2-hardcore-4-u/RobotDesign2025/Latex/readme.txt

Latex-Vorlage zur Erstellung eines Laborberichtes

Empfohlene Software:

Miktex als Latex-Engine

Als Latex-Editor 
TexnicCenter (Freeware, http://www.toolscenter.org/front_content.php?idcat=26)

Jabref (Freeware, http://sourceforge.net/projects/jabref/) für die Bibliotheksverwaltung
