2-hardcore-4-u/RobotDesign2025/report.pdf

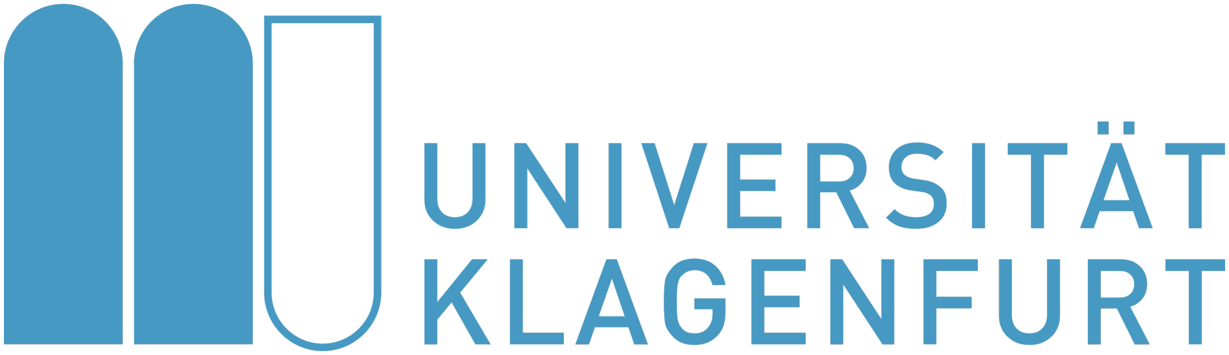
[picture p13: figure]

## University of Klagenfurt

# Basic Lab: Robot Design

## Summer Semester 2024

# Final Report

## Group B

## Bozhidar Bozhikov Nikita Smolianinov Vladyslav Uhrik

## Supervisors: Dr. Narendiran Anandan Serkan Ergun July 11, 2025

## Contents

1 Task Description (Bozhidar Bozhikov) | 2
2 Specifications (Bozhidar Bozhikov, Vladyslav Uhrik) | 2
3 Hardware and CAD (Nikita Smolianinov) | 5
4 PCB (Bozhidar Bozhikov) | 6
5 Discussion (Bozhidar Bozhikov) | 6

1

KS Basic Lab: Robot Design | SS 2025

## 1 Task Description (Bozhidar Bozhikov)

The goal behind this project is to design a circular robot (diam. = 30cm) with nominal speed 100mm/s. The robot must also fullfill the following requirements:

a) be able to clear gaps of 6cm,
b) be able to operate in darkness,
c) be able to run for a minimum of 15 minutes,
d) have line-tracking capability,
e) have RC capability,
f) be able to give acoustic feedback ( 75dB)
g) have maximum weight 800g,
h) fit in a budget of 300¤

The design we decided to develop is inspired by real-world screw-propelled vehicles, which are moved with the help of a pair of rotating helix-shaped cylinders made of soft plastic or rubber. The cylinders have a spiral form like the thread of a screw which make contact with the ground. Motion is produced by the inverse of the screw conveyor: one cylinder’s helix runs clockwise and the other - counterclockwise. Rotation is done with the activation of only one of the corresponding cylinders. This form of propulsion is used in real life to move through difficult terrain such as ice, mud, snow and water. As such, our robot would ideally operate on carpet (simulating mud and swamp) or on very smooth ground (simulating ice).
The github repository used can be found here. (https://github.com/2-hardcore-4-u/RobotDesign2025)

## 2 Specifications (Bozhidar Bozhikov, Vladyslav Uhrik)

### 2.1 Physical Calculations (Vladyslav Uhrik)

Step 1: Define Requirements Target speed = 0.1 m/s (100 mm/s) Helix pitch (measured or estimated) = 2 cm = 0.02 m Robot mass = 0.8 kg Wheel radius = 6 cm = 0.06 m Surface type = linoleum or carpet friction coefficient µ=0.4

2

Step 2: Calculate Required RPM We assume 1 full revolution of the helix moves the robot forward by 1 pitch length.

Revolutions per second (RPS) = Linear speed Helix pitch =

0.1
0.02

= 5 rev/sec

Helix pitch = the axial distance (i.e., forward movement along the wheel’s centerline) that the thread travels in one full 360◦
rotation around the wheel.

RPM = 5 * 60 = 300 RPM

Step 3: Calculate Normal Force per Wheel Assume equal weight distribution across two wheels:

FN =

m · g
2

=

0.8 kg × 9.81 m/s²

2
= 3.924 N
Step 4: Calculate Friction Force (Required to Move)

Ffriction = µ · FN
= 0.4 × 3.924 N
= 1.57 N
Step 5: Calculate Required Torque per Wheel

τ = F · r
= 1.57 N × 0.06 m
= 0.0942 Nm

Apply Safety Margin (1.5Ö)

τsafe = 0.0942 × 1.5
= 0.1413 N m
Step 6: Convert RPM to Angular Velocity

ω =

2π × RPM
60

=

2π × 300
60
= 31.42 rad s⁻¹

3

Step 7: Calculate Mechanical Power per Motor

P = τ × ω
= 0.1413 N m × 31.42 rad s⁻¹

= 4.44W per motor

Total Power for 2 Motors

Pmotors = 2 × 4.44W
= 8.88W

### 2.2 Electrical Power Calculations (Vladyslav Uhrik)

Step 8: System Power Budget We calculate the power P of each component using the formula: P = V I

Table 1: Component Power Consumption
Component | V (V) I (A) P (W) Notes
ATmega32 | 5.0 | 0.020 | 0.10 | Powered from 5V rail
8P MCU
nRF24L01 | 3.3 | 0.012 | 0.04 | Powered from 3.3V rail

P RF module

VL53L1X | 2.8 | 0.019 | 0.05 | Direct 2.8V rail or on- board LDO

ToF sensor

TP4056 | 5.0 | 1.000 | 5.00 | During charging (in- put)

charger module

MT3608 | 12.0 | 0.010 | 0.12 | Estimated conversion overhead

(regulator loss)

IIM-42652 | 3.3 | 0.007 | 0.023 | Motion tracking
CNY70 | 5.0 | 0.018 | 0.09 | IR sensor (emitter + transistor)

IR sensor

Buzzer (passive) | 5.0 | 0.030 | 0.15 | Approx. 75 dB
2x Pololu Stepper | 2.8 | 3.400 | 9.52 | Two motors: 1.7 A×2
Motors

Total Power = 24.613 W

| | 4

Step 9: Energy Required for 15 Minutes Convert 15 min to hours:

E = 24.613 ∗ 0.25 = 6.15325W h

Step 10: Calculate Battery Capacity at 12V

C =

6.15325
12
= 512.77 mA h

Add 30% Safety Margin:

Csafe = 512.77 × 1.3
= 666.6 mA h

Voltage: 12 V

Minimum capacity: 670 mA h (rounded up) (we end up using a 1000 mA h battery)

## 3 Hardware and CAD (Nikita Smolianinov)

The Fusion model discussed in this section can be found in the .stp file. The robot’s design follows real-world screw-propelled vehicles such as the ZIL-2906 and other Amphirols. The circular mount of the robot is made from 4mm thick plywood, with the propulsion cylinders attached with a custom 3D-printed mount, which are driven by 2 bipolar stepper motors, chosen for their power and precision. The stepper motors provide 3 degrees of movement.


Figure 1: Bottom-down view of the CAD model.

5

## 4 PCB (Bozhidar Bozhikov)

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

GPIO08: RF chip select

GPIO09: RF MISO

GPIO10: RF MOSI

GPIO11: RF clock

GPIO12: IR sensor 1

GPIO13: IR sensor 2

GPIO22, GPIO23: pulse input (STEP) and direction control (DIR) respectively for motor 1

GPIO24, GPIO25: pulse input (STEP) and direction control (DIR) respectively for motor 2

GPIO26: buzzer

GPIO27: RF enable

## 5 Discussion (Bozhidar Bozhikov)

The robot discussed in this report follows a real-world practical, albeit unorthodox, design utilizing the screw conveyor mechanism for propulsion on rough carpeted surfaces or smooth ground with 3 degrees of movement.

6


Figure 2: nRF24L01+ single-chip RF transciever, featuring a 16Mhz clock and an antenna.


Figure 3: Motor driver sub-circuit.


Figure 4: Top-down view of the custom pcb.

7
