2-hardcore-4-u/RobotDesign2025/Latex/Figures/1926_Fordson_snowmobile.jpg

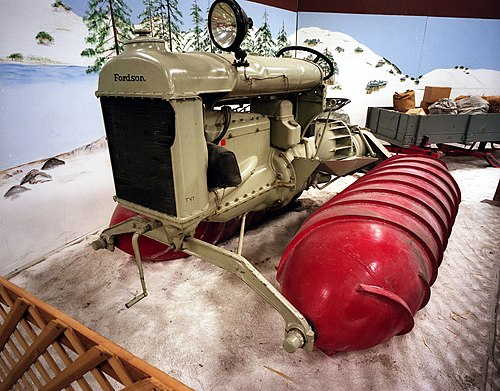
Latex/Figures/1926_Fordson_snowmobile.jpg
