2-hardcore-4-u/RobotDesign2025/BillOfMaterials/Bill of Materials.xlsx

Cost Overview
Item | Cost per Unit €/Unit | Units | Sum | Source /Comment
PLA [kg] | 30 | 0.25 | 7.5 | [1]
Electricity [hrs] | 0.06 | 10 | 0.6 | [1]
Bipolar Stepper Motor [pcs] | 32 | 2 | 64 | [2]
Custom PCB [pcs] | 50 | 1 | 50 | [1]
Small parts [pcs] | 0.5 | 20 | 10 | [1]
Loudspeaker [pcs] | 7 | 1 | 7 | [2]
Microcontroller [pcs] | 2.37 | 1 | 2.37 | [2]
RF Transciever [pcs] | 3.65 | 1 | 3.65 | [3]
Time of Flight Sensor [pcs] | 9.61 | 1 | 9.61 | [4]
Battery Charger Module [pcs] | 1.58 | 1 | 1.58 | [5]
DC Regulator [pcs] | 1.75 | 1 | 1.75 | [6]
6 Axis IMU [pcs] | 6.53 | 1 | 6.53 | [7]
Proximity Sensor [pcs] | 0.74 | 2 | 1.48 | [8]
Raspberry Pi 4 [pcs] | 54 | 1 | 54 | [9]
Battery [pcs] | 12.27 | 1 | 12.27
max allowed cost |  | 300 | 232.34
Sources:
[1] Values as found in template
[2] Document Atmel-7810-Automotive-Microcontrollers-ATmega328P_Datasheet.pdf
[3] Document nRF24L01P_Product_Specification_1_0
[4] Document vl53l1x-1.pdf
[5] Document TP4056.pdf
[6] Document MT3608.pdf
[7] Document ds-000440-iim-42652-typ-v1.1.pdf
[8] Document Atmel-7810-Automotive-Microcontrollers-ATmega328P_Datasheet.pdf
[9] Document raspberry-pi-4-datasheet.pdf
