2-hardcore-4-u/RobotDesign2025/Latex/Figures/UNI_KLU_Logo_cmyk.pdf

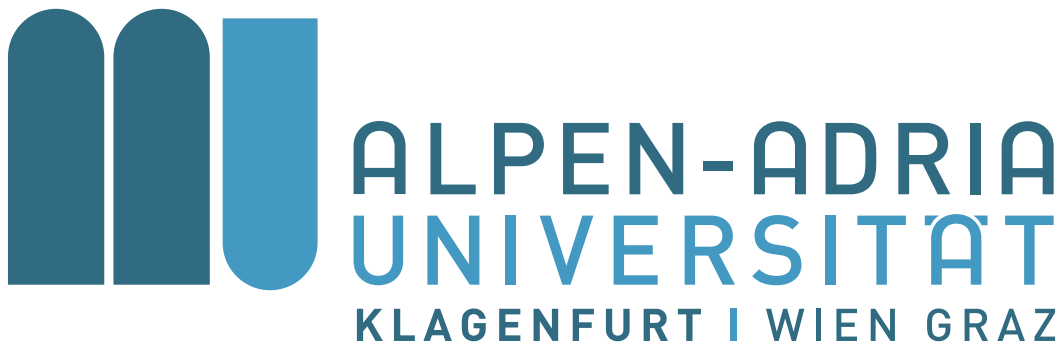
[picture p16: page 1]
