2-hardcore-4-u/RobotDesign2025/pcb/robotdesign.kicad_pcb

## KiCad design pcb/robotdesign.kicad_pcb (2025-06-23)

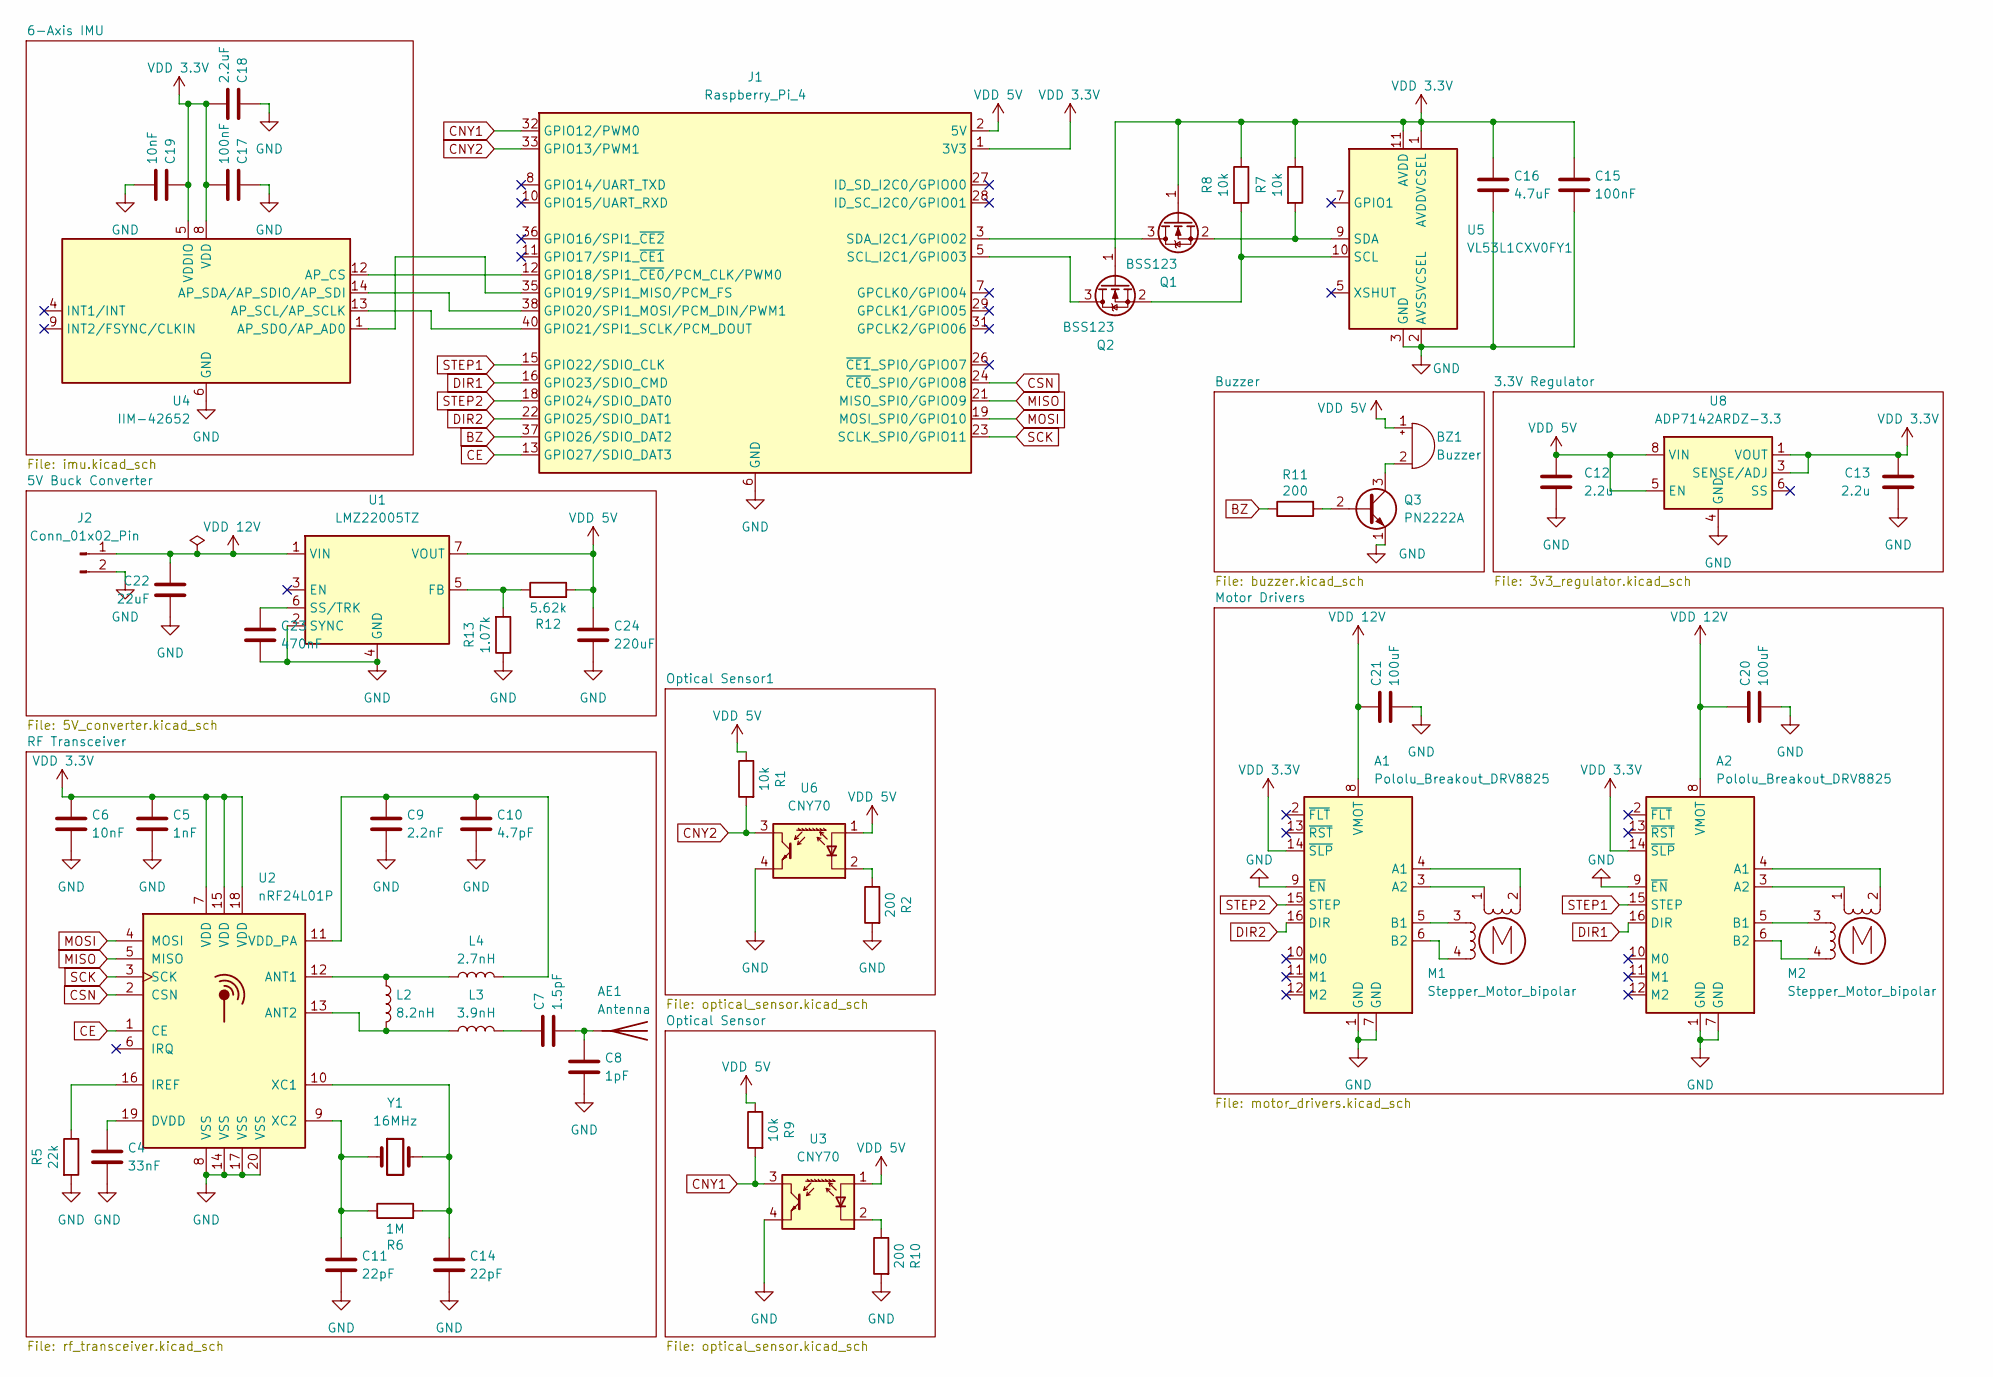
[picture p17: schematic robotdesign.kicad_sch]

Parts:
A1, A2: Pololu_Breakout_DRV8825; Pololu_Breakout-16_15.2x20.3mm
AE1: Antenna; NiceRF_SW868-TH13_868Mhz
BZ1: Buzzer; Buzzer_12x9.5RM7.6
C4: 33nF; C_0201_0603Metric
C5: 1nF; C_0201_0603Metric
C6, C19: 10nF; C_0201_0603Metric
C7: 1.5pF; C_0201_0603Metric
C8: 1pF; C_0201_0603Metric
C9: 2.2nF; C_0201_0603Metric
C10: 4.7pF; C_0201_0603Metric
C11, C14: 22pF; C_0201_0603Metric
C12, C13: 2.2u; C_0805_2012Metric
C15, C17: 100nF; C_0201_0603Metric
C16: 4.7uF; C_0201_0603Metric
C18: 2.2uF; C_0201_0603Metric
C20, C21: 100uF; C_0201_0603Metric
C22: 22uF; C_0201_0603Metric
C23: 470nF; C_0201_0603Metric
C24: 220uF; C_0201_0603Metric
J1: Raspberry_Pi_4; PinHeader_2x20_P2.54mm_Vertical
J2: Conn_01x02_Pin; AMASS_XT30U-F_1x02_P5.0mm_Vertical
L2: 8.2nH; L_6.3x6.3_H3
L3: 3.9nH; L_6.3x6.3_H3
L4: 2.7nH; L_6.3x6.3_H3
M1, M2: Stepper_Motor_bipolar; PinHeader_1x04_P2.54mm_Vertical
Q1, Q2: BSS123; SOT-23
Q3: PN2222A; TO-92_Inline
R1, R7, R8, R9: 10k; R_0201_0603Metric
R2, R10, R11: 200; R_0201_0603Metric
R5: 22k; R_0201_0603Metric
R6: 1M; R_0201_0603Metric
R12: 5.62k; R_0201_0603Metric
R13: 1.07k; R_0201_0603Metric
U1: LMZ22005TZ; Texas_NDW-7_TabPin4
U2: nRF24L01P; QFN-20-1EP_4x4mm_P0.5mm_EP2.5x2.5mm
U3, U6: CNY70; Vishay_CNY70
U4: IIM-42652; Bosch_LGA-14_3x2.5mm_P0.5mm
U5: VL53L1CXV0FY1; ST_VL53L1x
U8: ADP7142ARDZ-3.3; SOIC-8-1EP_3.9x4.9mm_P1.27mm_EP2.29x3mm
Y1: 16MHz; Crystal_AT310_D3.0mm_L10.0mm_Horizontal

Connections:
BZ: J1.37 (GPIO26/SDIO_DAT2), R11.1
CE: J1.13 (GPIO27/SDIO_DAT3), U2.1 (CE)
CNY1: J1.32 (GPIO12/PWM0), R9.2, U3.3 (C)
CNY2: J1.33 (GPIO13/PWM1), R1.2, U6.3 (C)
CSN: J1.24 (~CE0_SPI0/GPIO08), U2.2 (CSN)
DIR1: A2.16 (DIR), J1.16 (GPIO23/SDIO_CMD)
DIR2: A1.16 (DIR), J1.22 (GPIO25/SDIO_DAT1)
GND: A1.1 (GND), A1.7 (GND), A1.9 (~EN), A2.1 (GND), A2.7 (GND), A2.9 (~EN), C4.2, C5.2, C6.2, C8.2, C9.2, C10.2, C11.2, C12.1, C13.1, C14.2, C15.2, C16.2, C17.1, C18.1, C19.2, C20.2, C21.2, C22.2, C23.2, C24.2, J1.6 (GND), J1.9 (GND), J1.14 (GND), J1.20 (GND), J1.25 (GND), J1.30 (GND), J1.34 (GND), J1.39 (GND), J2.2, Q3.1 (E), R2.2, R5.2, R10.2, R13.1, U1.2 (SYNC), U1.4 (GND), U2.8 (VSS), U2.14 (VSS), U2.17 (VSS), U2.20 (VSS), U3.4 (E), U4.6 (GND), U4.7 (GND), U5.2 (AVSSVCSEL), U5.3 (GND), U5.4 (GND), U5.6 (GND), U5.12 (GND), U6.4 (E), U8.4 (GND), U8.9 (GND)
MISO: J1.21 (MISO_SPI0/GPIO09), U2.5 (MISO)
MOSI: J1.19 (MOSI_SPI0/GPIO10), U2.4 (MOSI)
unnamed: A1.4 (A1), M1.2 (-)
unnamed: A1.3 (A2), M1.1
unnamed: A1.5 (B1), M1.3
unnamed: A1.6 (B2), M1.4
unnamed: A2.4 (A1), M2.2 (-)
unnamed: A2.3 (A2), M2.1
unnamed: A2.5 (B1), M2.3
unnamed: A2.6 (B2), M2.4
unnamed: AE1.1 (A), C7.2, C8.1
unnamed: BZ1.2 (-), Q3.3 (C)
unnamed: C7.1, L3.2
unnamed: J1.12 (GPIO18/SPI1_~CE0/PCM_CLK/PWM0), U4.12 (AP_CS)
unnamed: J1.35 (GPIO19/SPI1_MISO/PCM_FS), U4.1 (AP_SDO/AP_AD0)
unnamed: J1.38 (GPIO20/SPI1_MOSI/PCM_DIN/PWM1), U4.14 (AP_SDA/AP_SDIO/AP_SDI)
unnamed: J1.40 (GPIO21/SPI1_SCLK/PCM_DOUT), U4.13 (AP_SCL/AP_SCLK)
unnamed: J1.5 (SCL_I2C1/GPIO03), Q2.3 (D)
unnamed: J1.3 (SDA_I2C1/GPIO02), Q1.3 (D)
unnamed: Q1.2 (S), R7.2, U5.9 (SDA)
unnamed: Q2.2 (S), R8.2, U5.10 (SCL)
unnamed: Q3.2 (B), R11.2
unnamed: R12.1, R13.2, U1.5 (FB)
unnamed: C23.1, U1.6 (SS/TRK)
unnamed: L2.1, L4.1, U2.12 (ANT1)
unnamed: L2.2, L3.1, U2.13 (ANT2)
unnamed: C4.1, U2.19 (DVDD)
unnamed: R5.1, U2.16 (IREF)
unnamed: C9.1, C10.1, L4.2, U2.11 (VDD_PA)
unnamed: C14.1, R6.2, U2.10 (XC1), Y1.2
unnamed: C11.1, R6.1, U2.9 (XC2), Y1.1
unnamed: R10.1, U3.2 (K)
unnamed: R2.1, U6.2 (K)
SCK: J1.23 (SCLK_SPI0/GPIO11), U2.3 (SCK)
STEP1: A2.15 (STEP), J1.15 (GPIO22/SDIO_CLK)
STEP2: A1.15 (STEP), J1.18 (GPIO24/SDIO_DAT0)
VDD 3.3V: A1.14 (~SLP), A2.14 (~SLP), C5.1, C6.1, C13.2, C15.1, C16.1, C17.2, C18.2, C19.1, J1.1 (3V3), J1.17 (3V3), Q1.1 (G), Q2.1 (G), R7.1, R8.1, U2.7 (VDD), U2.15 (VDD), U2.18 (VDD), U4.5 (VDDIO), U4.8 (VDD), U5.1 (AVDDVCSEL), U5.11 (AVDD), U8.1 (VOUT), U8.2 (VOUT), U8.3 (SENSE/ADJ)
VDD 5V: BZ1.1 (+), C12.2, C24.1, J1.2 (5V), J1.4 (5V), R1.1, R9.1, R12.2, U1.7 (VOUT), U3.1 (A), U6.1 (A), U8.5 (EN), U8.7 (VIN), U8.8 (VIN)
VDD 12V: A1.8 (VMOT), A2.8 (VMOT), C20.1, C21.1, C22.1, J2.1, U1.1 (VIN)

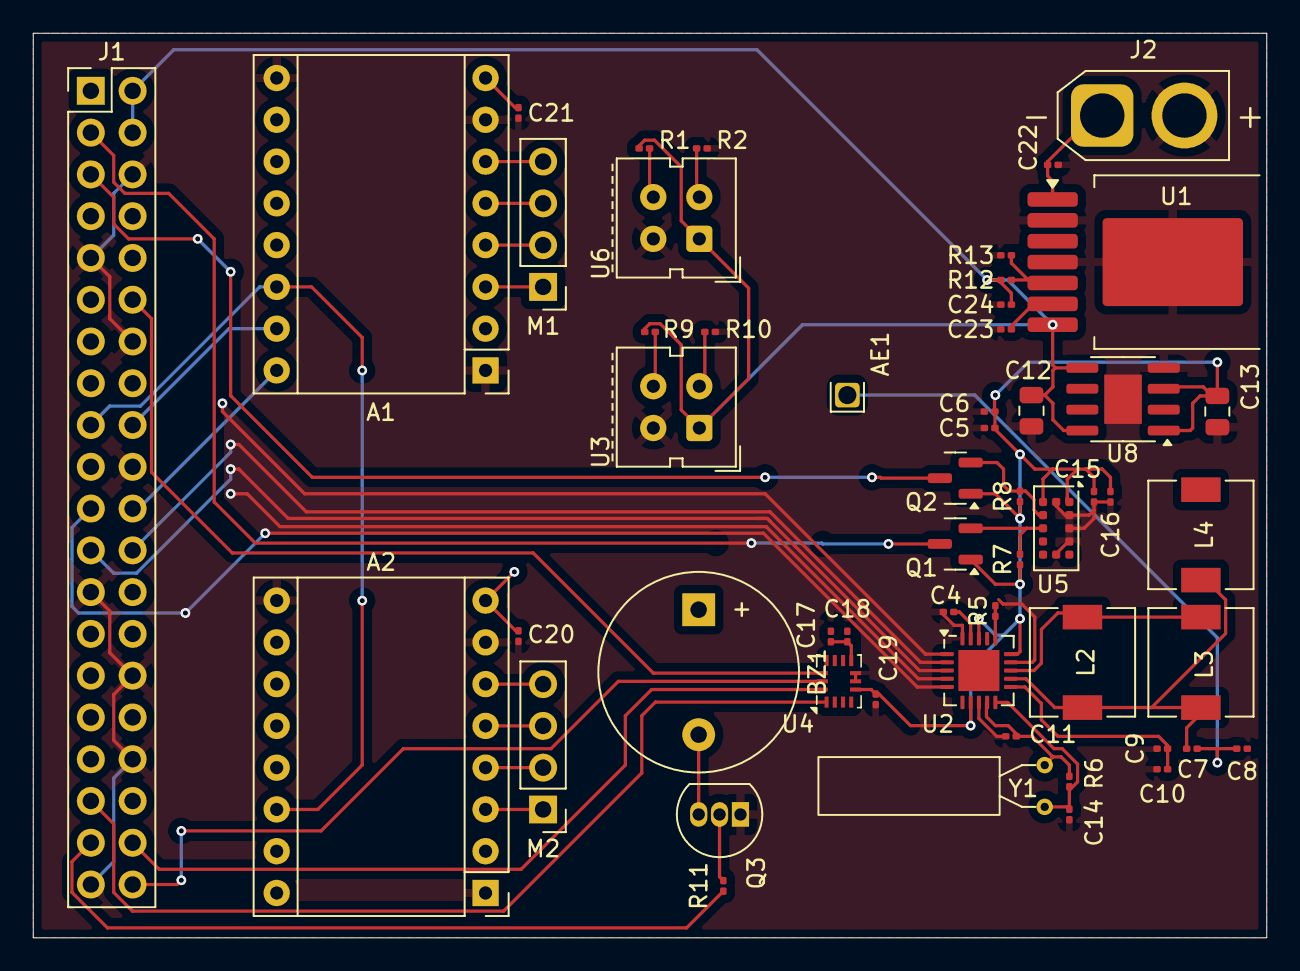
[picture p18: board robotdesign.kicad_pcb from above]

Board: 4 copper layers, 75.0 x 55.0 mm, 54 parts (0 on the bottom side), 47 nets.
