2-hardcore-4-u/RobotDesign2025/(commit log)

2025-06-22 circuit v1
    [3v3_regulator.kicad_sch, 5V_converter.kicad_sch, buzzer.kicad_sch, imu.kicad_sch, lab_example.kicad_pcb, lab_example.kicad_sch, motor_drivers.kicad_sch, optical_sensor.kicad_sch]
2025-07-10 bill of materials and report
    [3v3_regulator.kicad_sch, 5V_converter.kicad_sch, Bill of Materials.xlsx, buzzer.kicad_sch, imu.kicad_sch, lab_example.kicad_pcb, lab_example.kicad_sch, motor_drivers.kicad_sch]
2025-07-11 final commit
    [Bill of Materials.xlsx]
